cjrnd/TEMiWCZ_BLDC_HW/README.md

# TEMiWCZ_BLDC_HW

A BLDC driver which utilizes FOC algorithm.
<br />
<br />

### PCB
<p align="center">
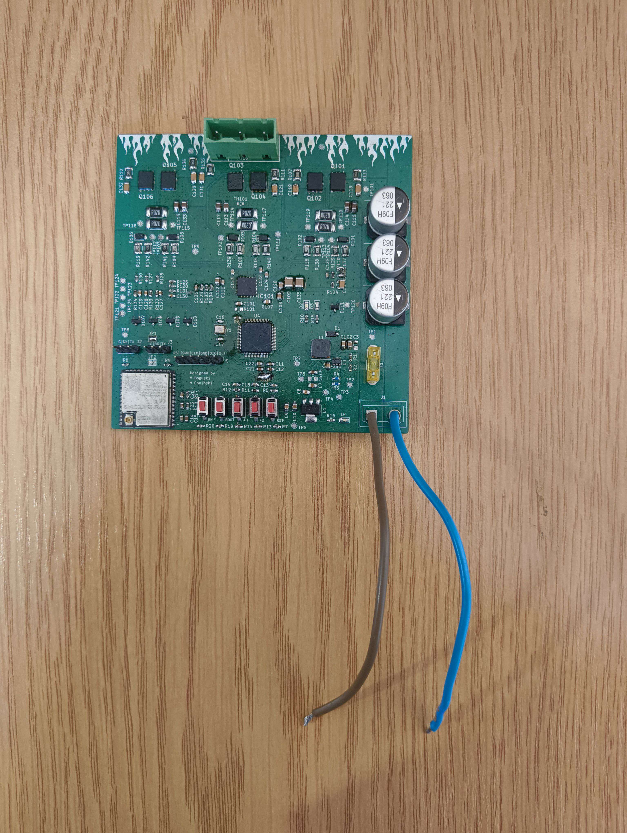
[picture p1: pictures/bldc_driver.jpg]
  
</p>

### TESTING

<p align="center">
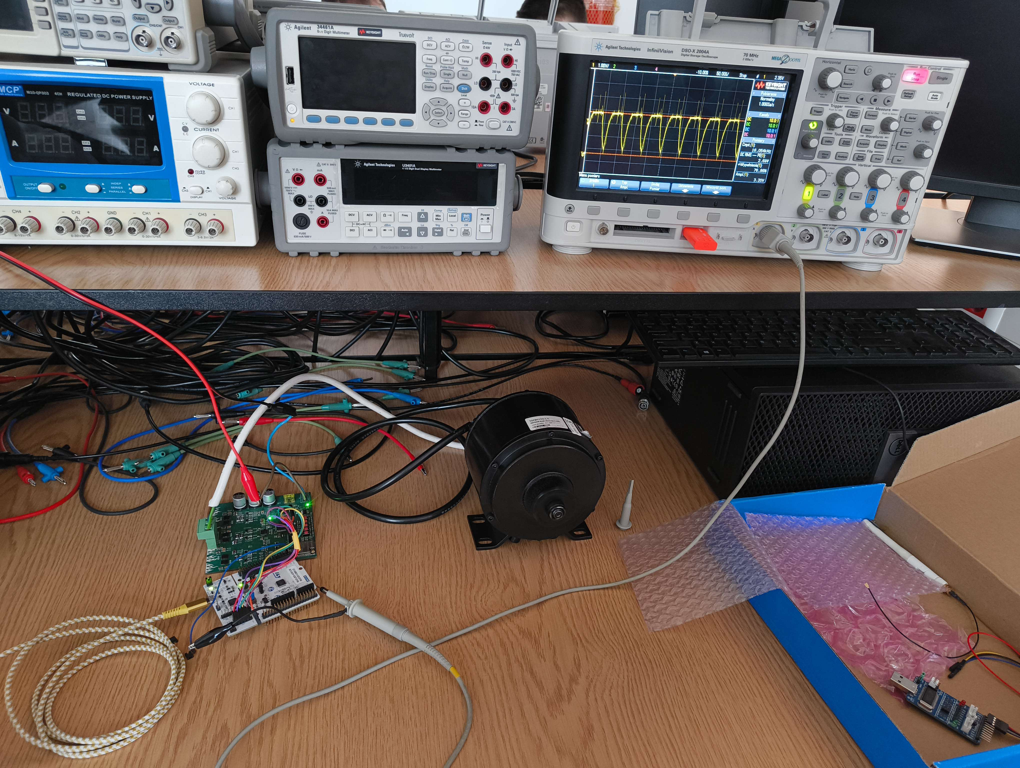
[picture p2: pictures/bldc_test.jpg]
  
</p>
