cjrnd/TEMiWCZ_BLDC_HW/BLDC_DRIVER/models&footprints/691311400103/Download_STP_691311400103_rev1.stp

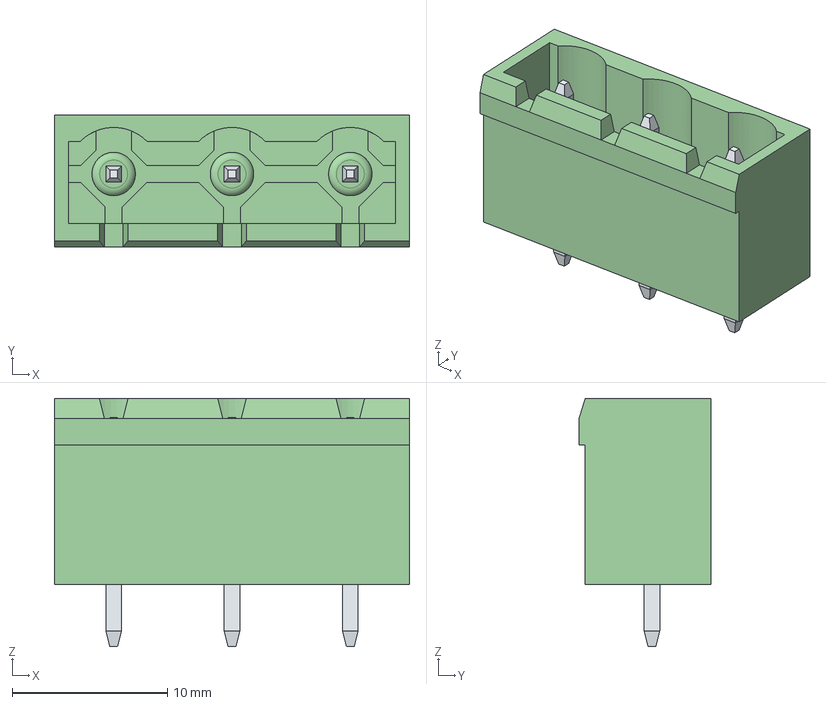
[picture p3: CAD file, 2025-04-12]
BLDC_DRIVER/models&footprints/691311400103/Download_STP_691311400103_rev1.stp
22.9 x 8.50 x 16.0 mm
6913114001xx_PIN x 3
