cjrnd/TEMiWCZ_BLDC_HW/BLDC_DRIVER/models&footprints/BAT54C/BAT54C.stp

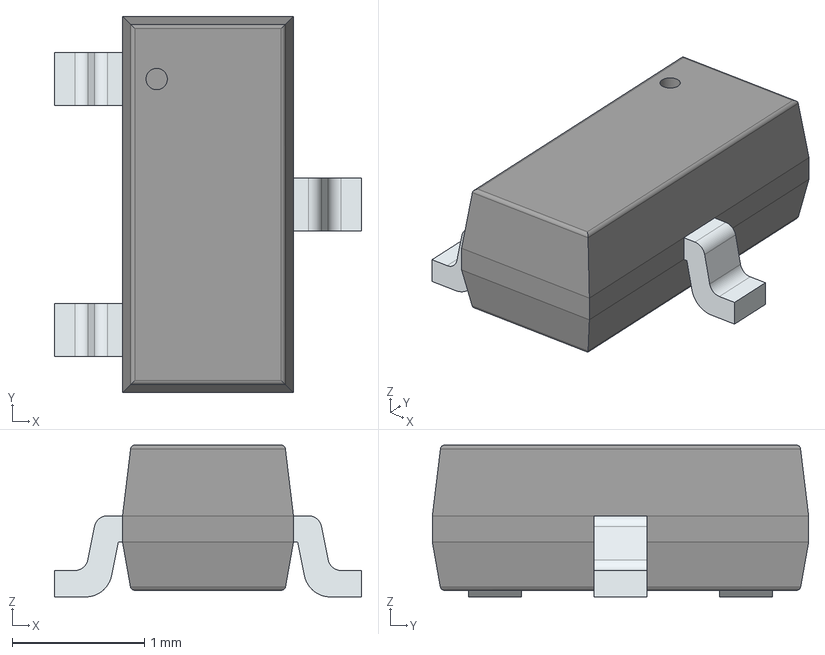
[picture p4: CAD file, 2025-04-06]
BLDC_DRIVER/models&footprints/BAT54C/BAT54C.stp
2.33 x 2.85 x 1.15 mm
PinsArrayL
FilletPinR
