cjrnd/TEMiWCZ_BLDC_HW/BLDC_DRIVER/models&footprints/BSC146N10LS5ATMA1/BSC146N10LS5ATMA1.stp

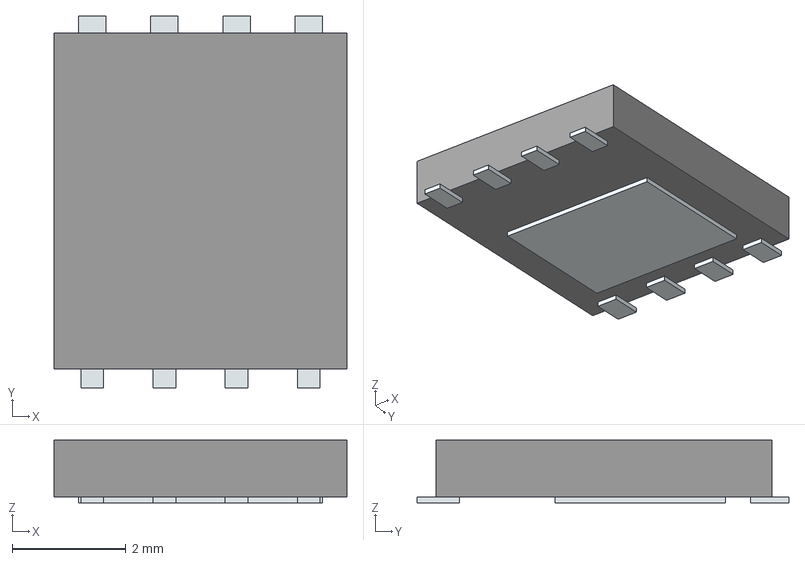
[picture p5: CAD file, 2025-04-12]
BLDC_DRIVER/models&footprints/BSC146N10LS5ATMA1/BSC146N10LS5ATMA1.stp
5.15 x 6.54 x 1.10 mm
Pins
