cjrnd/TEMiWCZ_BLDC_HW/BLDC_DRIVER/models&footprints/CDBC560-G/CDBC560-G.stp

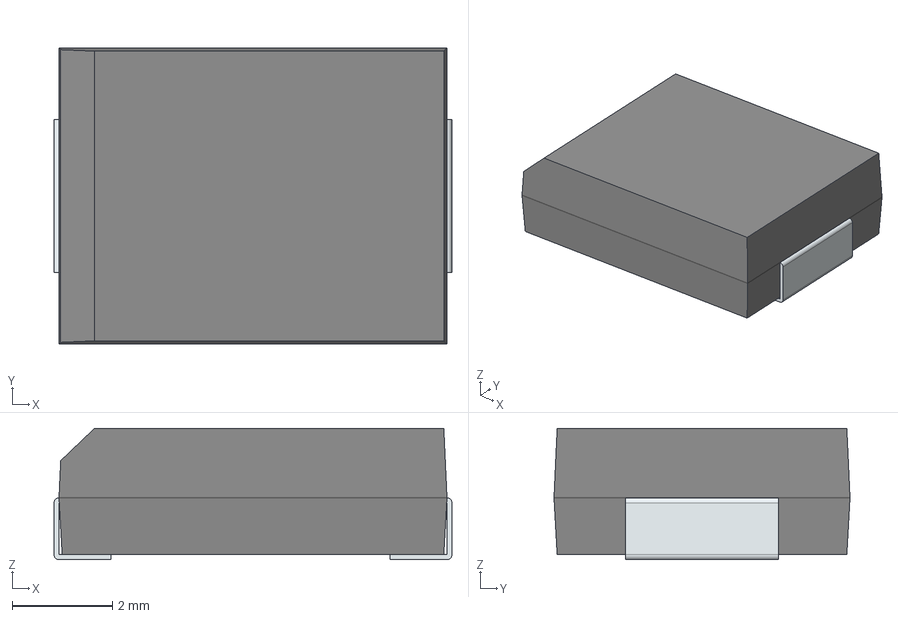
[picture p6: CAD file, 2025-04-12]
BLDC_DRIVER/models&footprints/CDBC560-G/CDBC560-G.stp
7.94 x 5.91 x 2.62 mm
FilletPin1
FilletPin2
