cjrnd/TEMiWCZ_BLDC_HW/BLDC_DRIVER/models&footprints/DRV8323/DRV8323SRTAR.stp

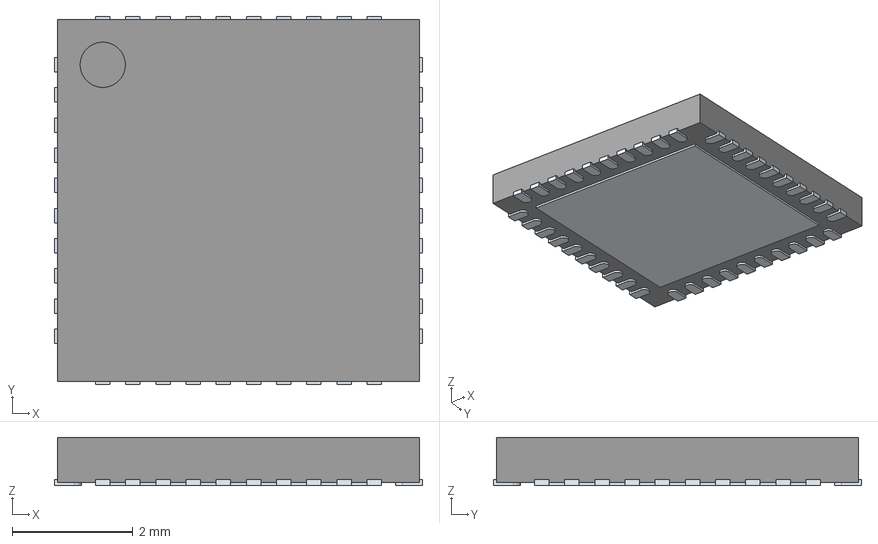
[picture p7: CAD file, 2025-04-06]
BLDC_DRIVER/models&footprints/DRV8323/DRV8323SRTAR.stp
6.10 x 6.10 x 0.8 mm
ThermalPin
PinsArrayLR
PinsArrayTB
