cjrnd/TEMiWCZ_BLDC_HW/BLDC_DRIVER/models&footprints/EMVY101ARA101MKE0S/EMVY101ARA101MKE0S.stp

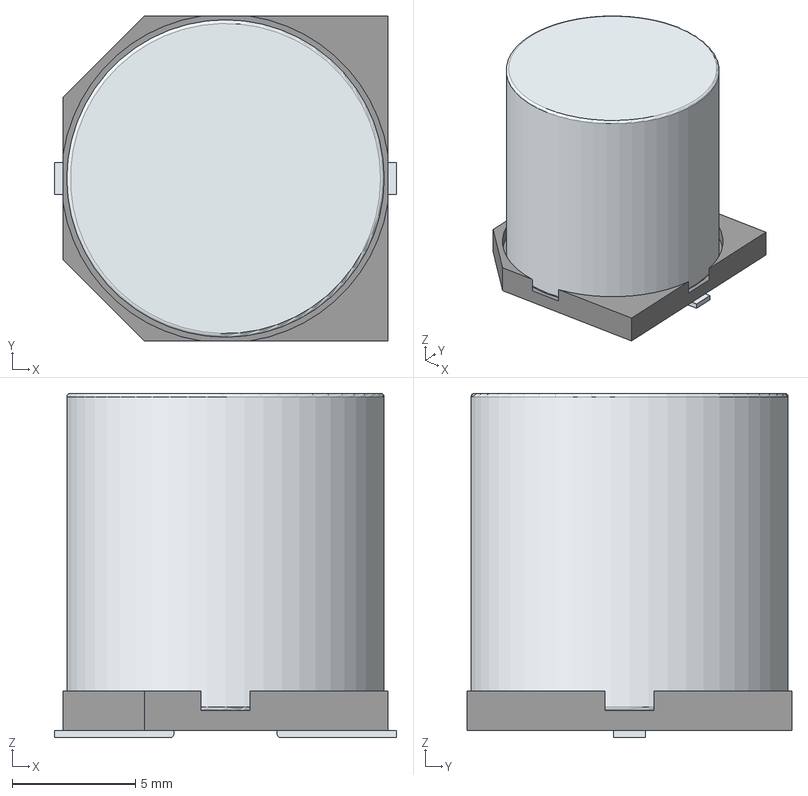
[picture p8: CAD file, 2025-04-06]
BLDC_DRIVER/models&footprints/EMVY101ARA101MKE0S/EMVY101ARA101MKE0S.stp
13.9 x 13.2 x 14.0 mm
Base
Pin1Fillet
Pin2Fillet
