cjrnd/TEMiWCZ_BLDC_HW/BLDC_DRIVER/models&footprints/ESP32-S3-WROOM-1U-N16R2/ESP32-S3-WROOM-1U-N16R2.step

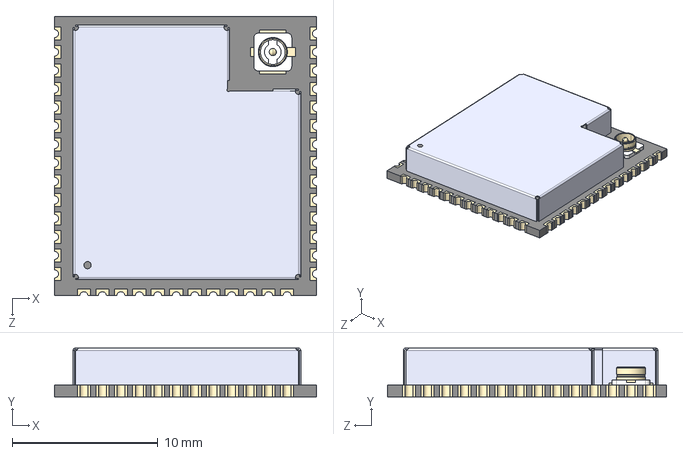
[picture p9: CAD file, 2025-04-09]
BLDC_DRIVER/models&footprints/ESP32-S3-WROOM-1U-N16R2/ESP32-S3-WROOM-1U-N16R2.step
18.0 x 3.35 x 19.2 mm
