cjrnd/TEMiWCZ_BLDC_HW/BLDC_DRIVER/models&footprints/NTMFS4D0N08XT1G/NTMFS4D0N08XT1G.stp

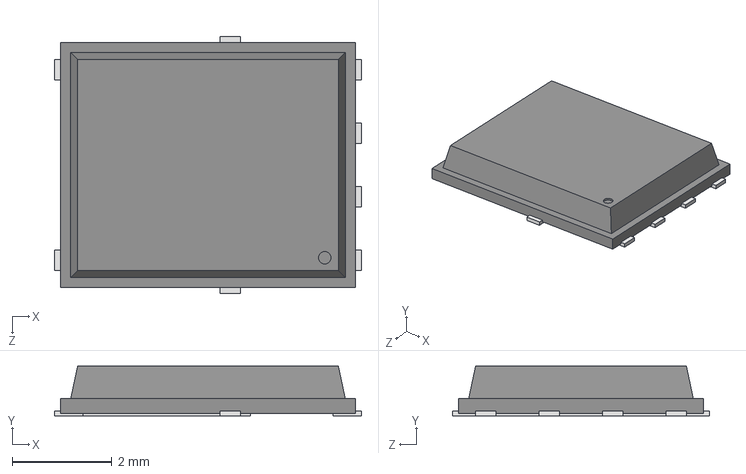
[picture p10: CAD file, 2025-04-16]
BLDC_DRIVER/models&footprints/NTMFS4D0N08XT1G/NTMFS4D0N08XT1G.stp
6.15 x 1 x 5.15 mm
