cjrnd/TEMiWCZ_BLDC_HW/BLDC_DRIVER/models&footprints/PM4343.102NLT/PM4343.102NLT.stp

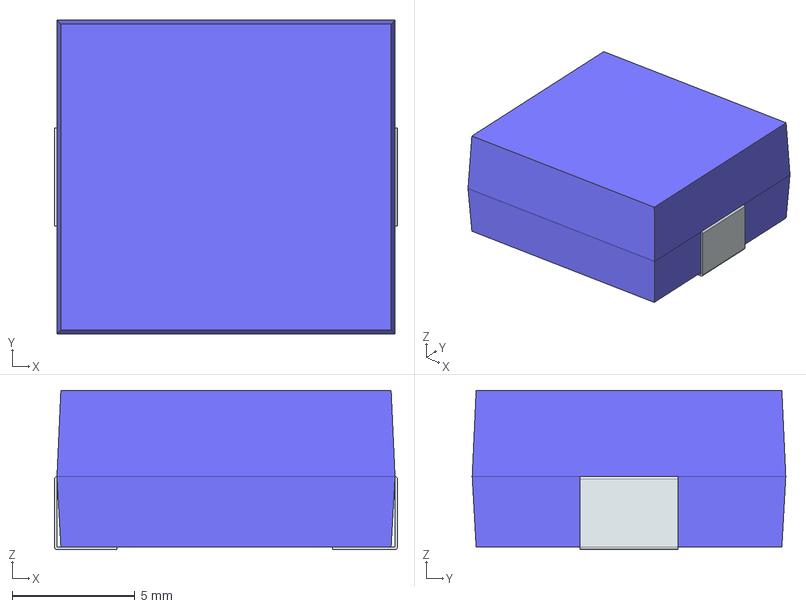
[picture p11: CAD file, 2025-04-06]
BLDC_DRIVER/models&footprints/PM4343.102NLT/PM4343.102NLT.stp
14.0 x 12.8 x 6.50 mm
FilletPin1
FilletPin2
