cjrnd/TEMiWCZ_BLDC_HW/BLDC_DRIVER/models&footprints/RF201L2SDDTE25/RF201L2SDDTE25.stp

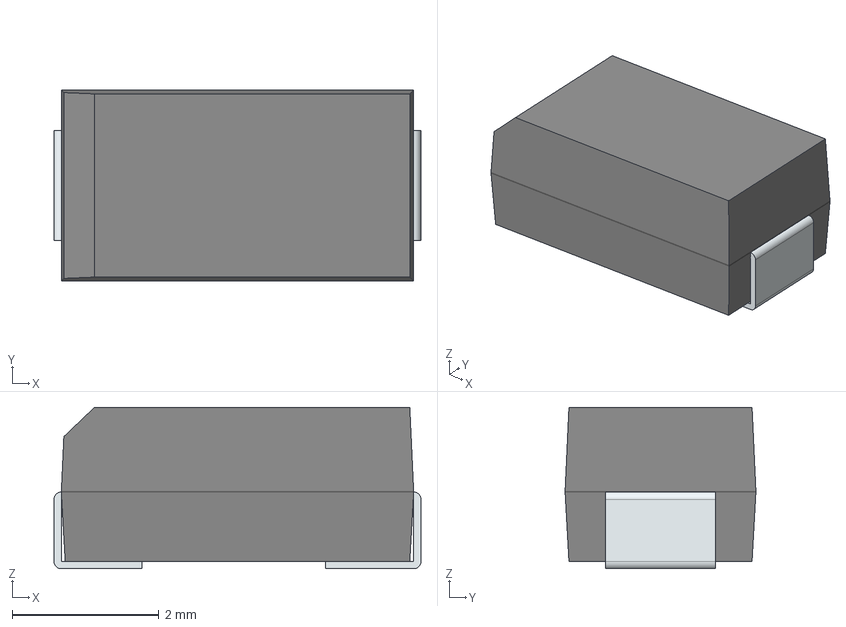
[picture p12: CAD file, 2025-04-06]
BLDC_DRIVER/models&footprints/RF201L2SDDTE25/RF201L2SDDTE25.stp
5.00 x 2.60 x 2.20 mm
FilletPin1
FilletPin2
