cjrnd/TEMiWCZ_BLDC_HW/BLDC_DRIVER/models&footprints/SBR3U60P1-7/SBR3U60P1-7.stp

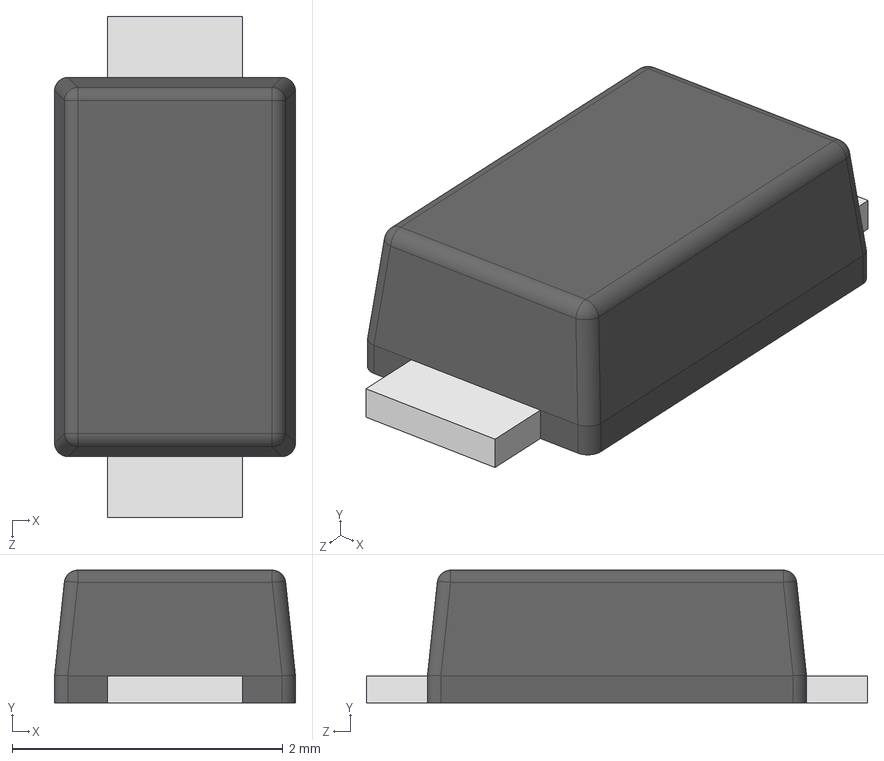
[picture p13: CAD file, 2025-04-12]
BLDC_DRIVER/models&footprints/SBR3U60P1-7/SBR3U60P1-7.stp
1.78 x 0.98 x 3.70 mm
