cjrnd/TEMiWCZ_BLDC_HW/BLDC_DRIVER/models&footprints/SBRT20U50SLPQ-13/SBRT20U50SLPQ-13.stp

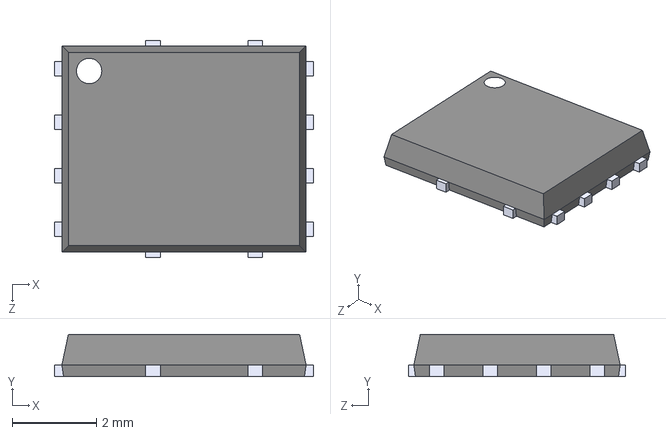
[picture p14: CAD file, 2025-04-12]
BLDC_DRIVER/models&footprints/SBRT20U50SLPQ-13/SBRT20U50SLPQ-13.stp
6.15 x 1.00 x 5.15 mm
