cjrnd/TEMiWCZ_BLDC_HW/BLDC_DRIVER/models&footprints/SQJ170ELP-T1_GE3/SQJ170ELP-T1_GE3.stp

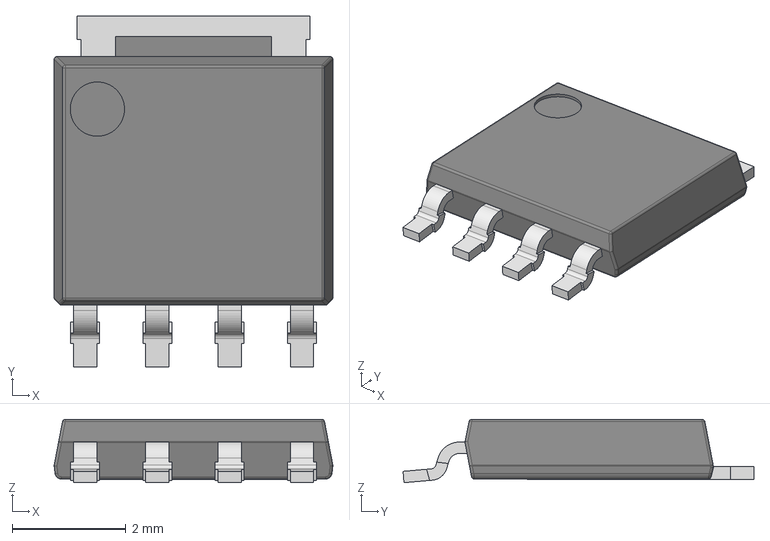
[picture p15: CAD file, 2025-04-06]
BLDC_DRIVER/models&footprints/SQJ170ELP-T1_GE3/SQJ170ELP-T1_GE3.stp
4.90 x 6.17 x 1.11 mm
