cjrnd/TEMiWCZ_BLDC_HW/BLDC_DRIVER/BLDC_DRIVER.kicad_pcb

## KiCad design BLDC_DRIVER/BLDC_DRIVER.kicad_pcb (2025-04-17)

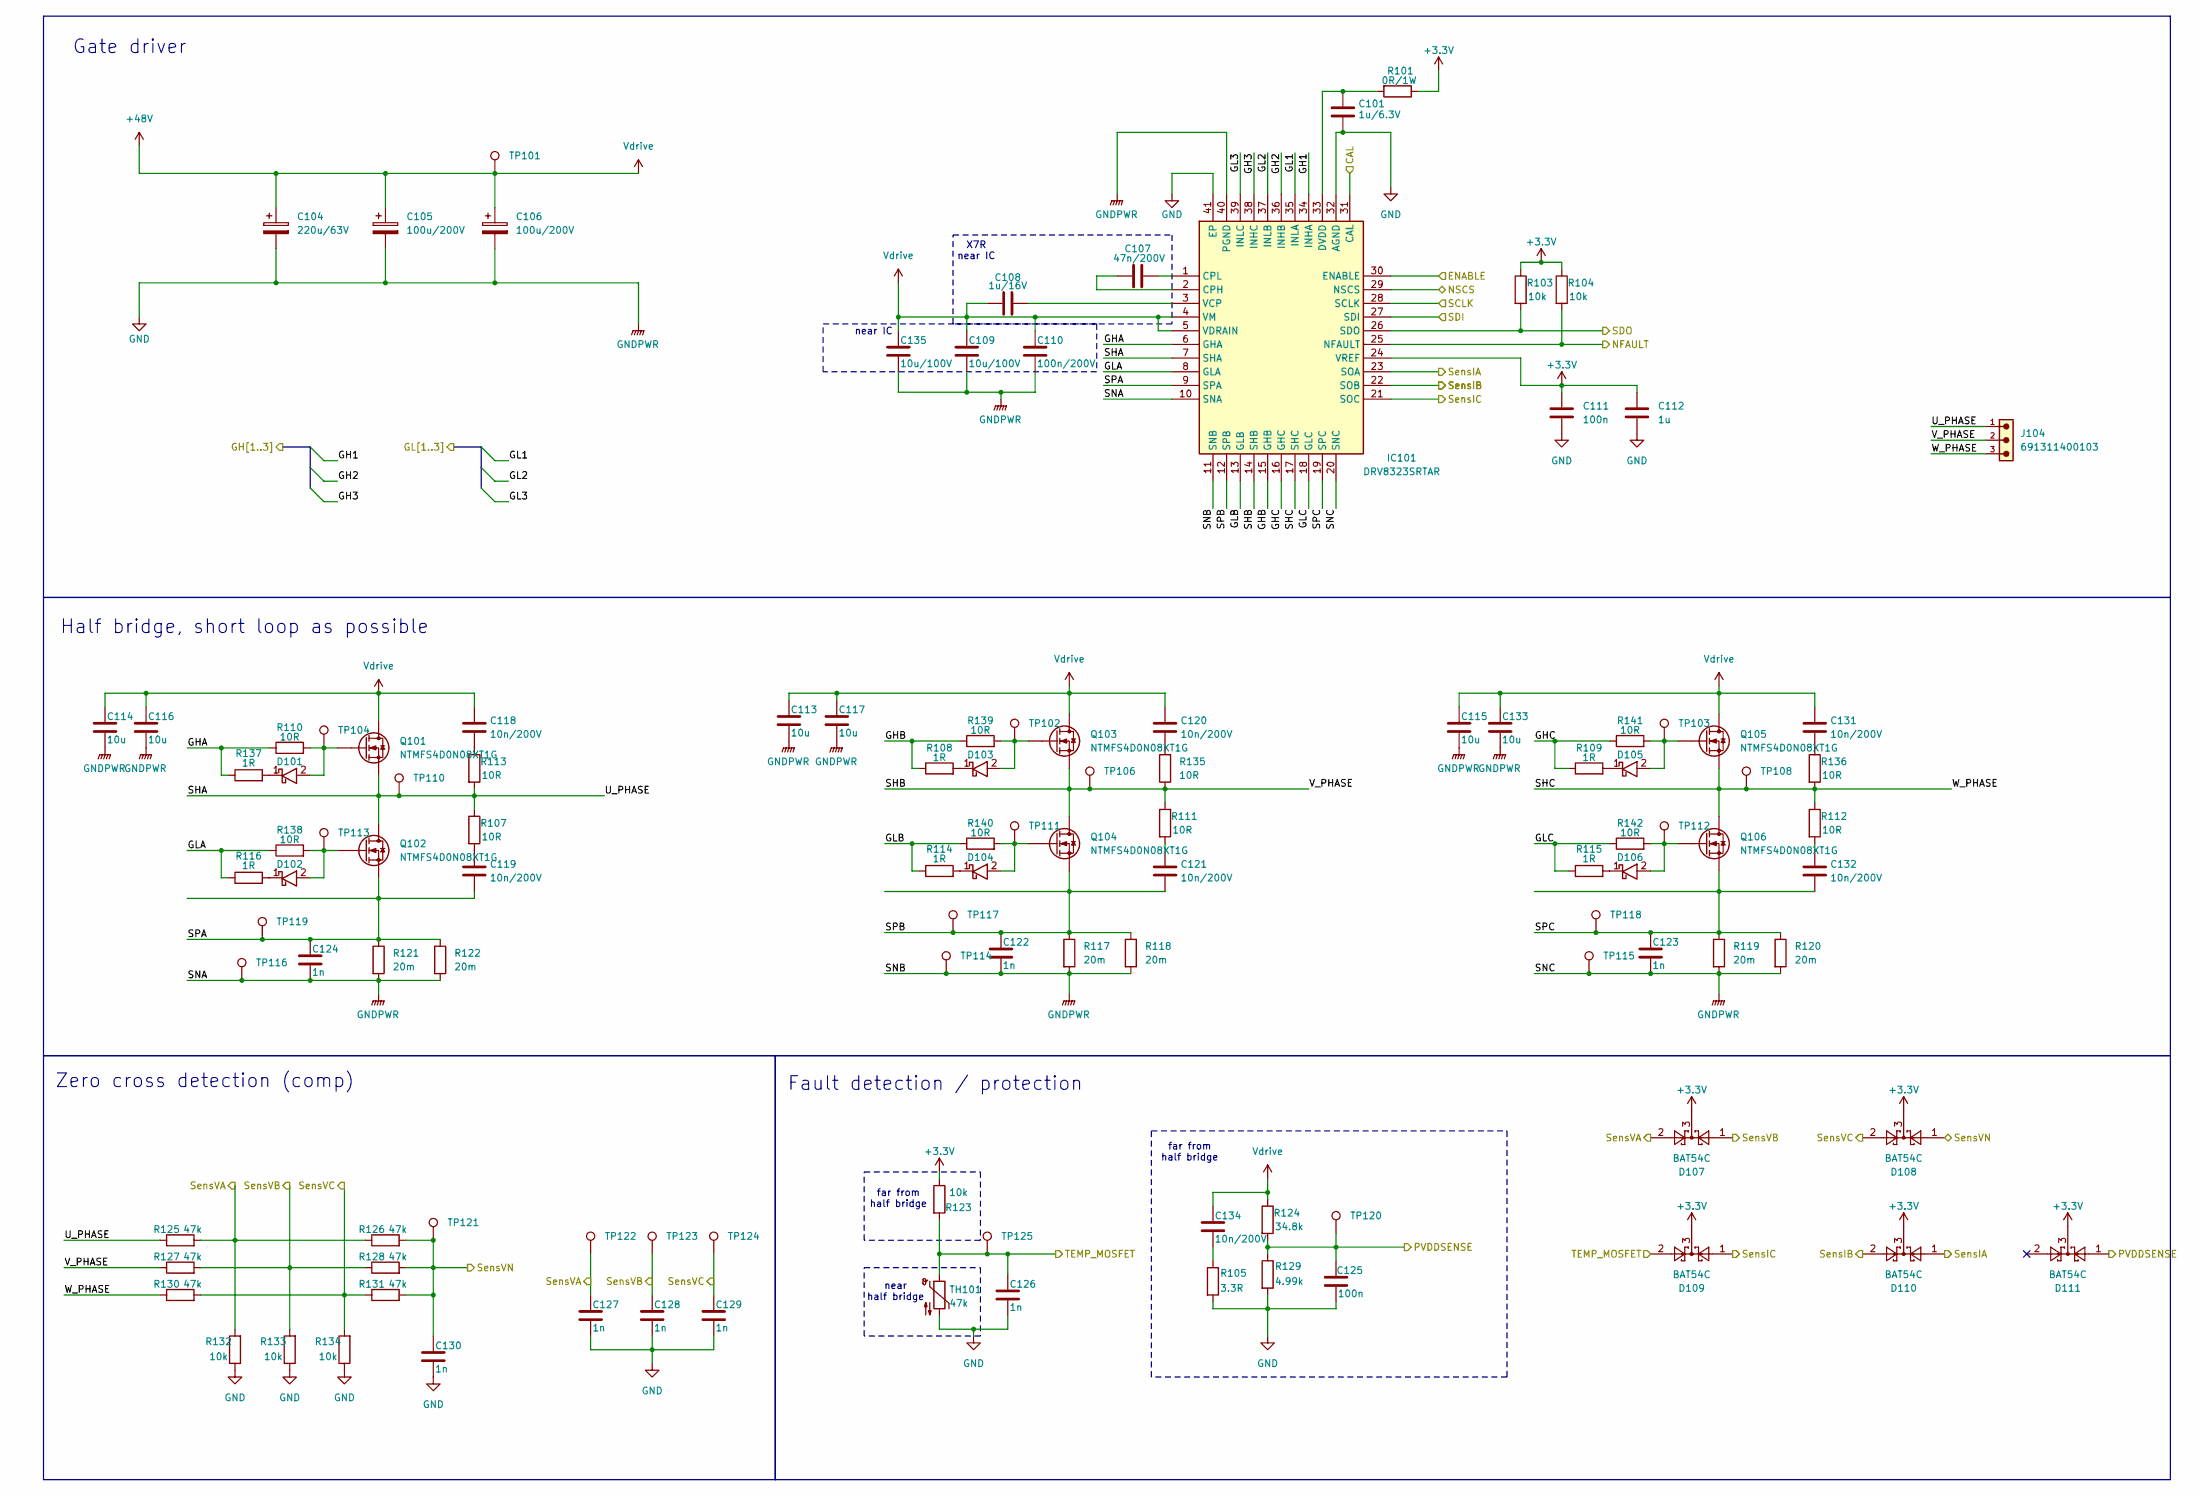
[picture p16: schematic Motor_driver.kicad_sch]

Parts:
C101: 1u/6.3V; C_0603_1608Metric
C104: 220u/63V; CAPAE1300X1400N
C105, C106: 100u/200V; CAPAE1300X1400N
C107: 47n/200V; C_0805_2012Metric
C108: 1u/16V; C_0805_2012Metric
C109, C135: 10u/100V; C_1210_3225Metric
C110: 100n/200V; C_0805_2012Metric
C111, C125: 100n; C_0603_1608Metric
C112: 1u; C_0805_2012Metric
C113, C114, C115, C116, C117, C133: 10u; C_1206_3216Metric
C118, C119, C120, C121, C131, C132: 10n/200V; C_1206_3216Metric
C122, C123, C124, C126, C127, C128, C129, C130: 1n; C_0603_1608Metric
C134: 10n/200V; C_0805_2012Metric
D101, D102, D103, D104, D105, D106: SBR3U60P1-7; D_PowerDI-123; Mouser Part Number 621-SBR3U60P1-7
D107, D108, D109, D110, D111: BAT54C; SOT-23
IC101: DRV8323SRTAR; QFN50P600X600X80-41N-D; Mouser Part Number 595-DRV8323SRTAR
J104: 691311400103
Q101, Q102, Q103, Q104, Q105, Q106: NTMFS4D0N08XT1G; NRVTS10100EMFST1G; Mouser Part Number 863-NTMFS4D0N08XT1G
R101: 0R/1W; R_0805_2012Metric
R103, R104, R123, R132, R133, R134: 10k; R_0603_1608Metric
R105: 3.3R; R_0805_2012Metric
R107, R110, R111, R112, R113, R135, R136, R138, R139, R140, R141, R142: 10R; R_1210_3225Metric
R108, R109, R114, R115, R116, R137: 1R; R_1210_3225Metric
R117, R118, R119, R120, R121, R122: 20m; R_2512_6332Metric
R124: 34.8k; R_0603_1608Metric
R125, R126, R127, R128, R130, R131: 47k; R_0603_1608Metric
R129: 4.99k; R_0603_1608Metric
TH101: 47k; R_0603_1608Metric
TP101, TP102, TP103, TP104, TP106, TP108, TP110, TP111, TP112, TP113, TP114, TP115, TP116, TP117, TP118, TP119, TP120, TP121, TP122, TP123, TP124, TP125: TestPoint; TestPoint_Pad_D1.5mm

Connections:
+3.3V: C111.1, C112.1, D107.3, D108.3, D109.3, D110.3, D111.3, IC101.24 (VREF), R101.1, R103.1, R104.1, R123.1; also elsewhere on the board
+48V: C104.1, C105.1, C106.1, C108.1, C109.1, C110.1, C113.1, C114.1, C115.1, C116.1, C117.1, C118.1, C120.1, C131.1, C133.1, C134.1, C135.1, IC101.4 (VM), IC101.5 (VDRAIN), Q101.5, Q103.5, Q105.5, R124.1, TP101.1; also elsewhere on the board
/MCU/CAL: IC101.31 (CAL); also elsewhere on the board
/MCU/ENABLE: IC101.30 (ENABLE); also elsewhere on the board
/MCU/GH1: IC101.34 (INHA); also elsewhere on the board
/MCU/GH2: IC101.36 (INHB); also elsewhere on the board
/MCU/GH3: IC101.38 (INHC); also elsewhere on the board
/MCU/GL1: IC101.35 (INLA); also elsewhere on the board
/MCU/GL2: IC101.37 (INLB); also elsewhere on the board
/MCU/GL3: IC101.39 (INLC); also elsewhere on the board
/MCU/NFAULT: IC101.25 (NFAULT), R104.2; also elsewhere on the board
/MCU/NSCS: IC101.29 (NSCS); also elsewhere on the board
/MCU/PVDDSENSE: C125.1, D111.1, R124.2, R129.1, TP120.1; also elsewhere on the board
/MCU/SCLK: IC101.28 (SCLK); also elsewhere on the board
/MCU/SDI: IC101.26 (SDO), R103.2; also elsewhere on the board
/MCU/SDO: IC101.27 (SDI); also elsewhere on the board
/MCU/SensIA: D110.1, IC101.23 (SOA); also elsewhere on the board
/MCU/SensIB: D110.2, IC101.22 (SOB); also elsewhere on the board
/MCU/SensIC: D109.1, IC101.21 (SOC); also elsewhere on the board
/MCU/SensVA: C127.1, D107.2, R125.2, R126.1, R132.2, TP122.1; also elsewhere on the board
/MCU/SensVB: C128.1, D107.1, R127.2, R128.1, R133.2, TP123.1; also elsewhere on the board
/MCU/SensVC: C129.1, D108.2, R130.2, R131.1, R134.2, TP124.1; also elsewhere on the board
/MCU/SensVN: C130.1, D108.1, R126.2, R128.2, R131.2, TP121.1; also elsewhere on the board
/MCU/TEMP_MOSFET: C126.1, D109.2, R123.2, TH101.1, TP125.1; also elsewhere on the board
/Motor_driver/GHA: IC101.6 (GHA), R110.1, R137.1
/Motor_driver/GHB: IC101.15 (GHB), R108.1, R139.1
/Motor_driver/GHC: IC101.16 (GHC), R109.1, R141.1
/Motor_driver/GLA: IC101.8 (GLA), R116.1, R138.1
/Motor_driver/GLB: IC101.13 (GLB), R114.1, R140.1
/Motor_driver/GLC: IC101.18 (GLC), R115.1, R142.1
/Motor_driver/SHA: IC101.7 (SHA), J104.1, Q101.1, Q102.5, R107.1, R113.2, R125.1, TP110.1
/Motor_driver/SHB: IC101.14 (SHB), J104.2, Q103.1, Q104.5, R111.1, R127.1, R135.1, TP106.1
/Motor_driver/SHC: IC101.17 (SHC), J104.3, Q105.1, Q106.5, R112.1, R130.1, R136.2, TP108.1
/Motor_driver/SPA: C119.2, C124.1, IC101.9 (SPA), Q102.1, R121.1, R122.1, TP119.1
/Motor_driver/SPB: C121.2, C122.1, IC101.12 (SPB), Q104.1, R117.1, R118.1, TP117.1
/Motor_driver/SPC: C123.1, C132.2, IC101.19 (SPC), Q106.1, R119.1, R120.1, TP118.1
GND: C101.2, C104.2, C105.2, C106.2, C109.2, C110.2, C111.2, C112.2, C113.2, C114.2, C115.2, C116.2, C117.2, C122.2, C123.2, C124.2, C125.2, C126.2, C127.2, C128.2, C129.2, C130.2, C133.2, C135.2, IC101.10 (SNA), IC101.11 (SNB), IC101.20 (SNC), IC101.32 (AGND), IC101.40 (PGND), IC101.41 (EP), R105.2, R117.2, R118.2, R119.2, R120.2, R121.2, R122.2, R129.2, R132.1, R133.1, R134.1, TH101.2, TP114.1, TP115.1, TP116.1; also elsewhere on the board
unnamed: C118.2, R113.1
unnamed: C119.1, R107.2
unnamed: C120.2, R135.2
unnamed: C121.1, R111.2
unnamed: C131.2, R136.1
unnamed: C132.1, R112.2
unnamed: C134.2, R105.1
unnamed: D101.1, R137.2
unnamed: D101.2, Q101.4, R110.2, TP104.1
unnamed: D102.1, R116.2
unnamed: D102.2, Q102.4, R138.2, TP113.1
unnamed: D103.1, R108.2
unnamed: D103.2, Q103.4, R139.2, TP102.1
unnamed: D104.1, R114.2
unnamed: D104.2, Q104.4, R140.2, TP111.1
unnamed: D105.1, R109.2
unnamed: D105.2, Q105.4, R141.2, TP103.1
unnamed: D106.1, R115.2
unnamed: D106.2, Q106.4, R142.2, TP112.1
unnamed: C107.1, IC101.2 (CPH)
unnamed: C107.2, IC101.1 (CPL)
unnamed: C101.1, IC101.33 (DVDD), R101.2
unnamed: C108.2, IC101.3 (VCP)

Notes on the sheet:
Fault detection / protection
Gate driver
far from half bridge
X7R near IC
Zero cross detection (comp)
near half bridge
near IC
Half bridge, short loop as possible

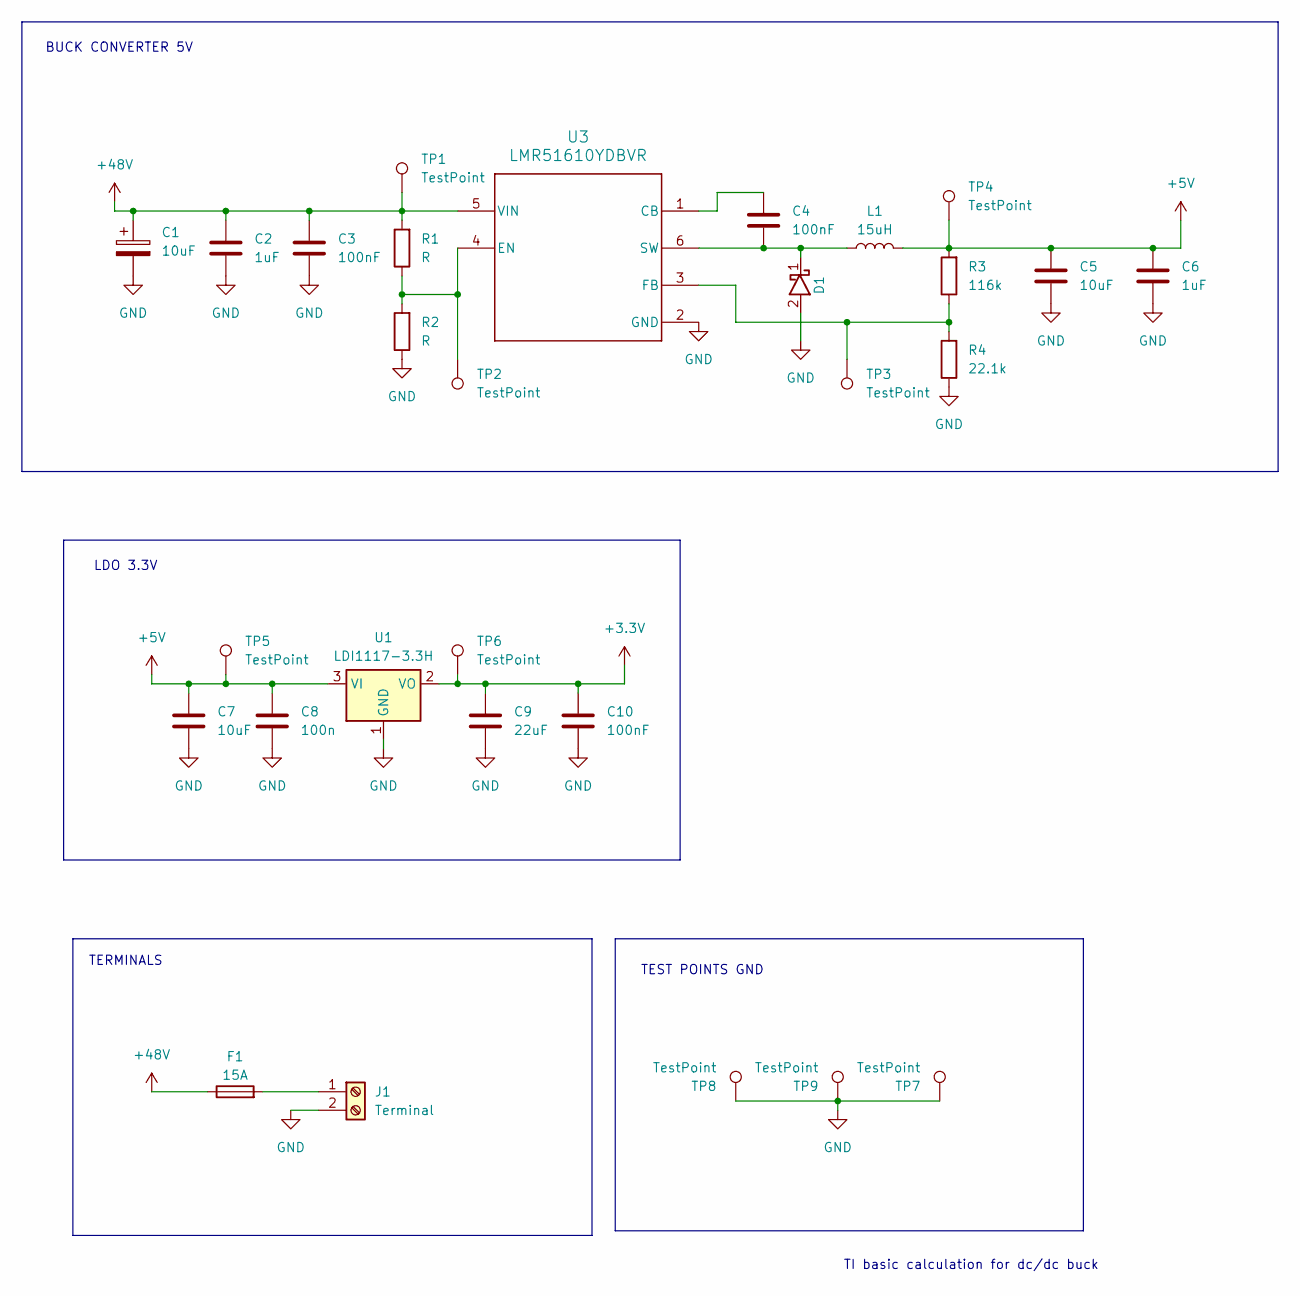
[picture p17: schematic power.kicad_sch]

Parts:
C1, C5, C7: 10uF; C_0805_2012Metric_Pad1.18x1.45mm_HandSolder
C2, C6: 1uF; C_0805_2012Metric_Pad1.18x1.45mm_HandSolder
C3, C10: 100nF; C_0805_2012Metric_Pad1.18x1.45mm_HandSolder
C4: 100nF; C_0603_1608Metric_Pad1.08x0.95mm_HandSolder
C8: 100n; C_0603_1608Metric_Pad1.08x0.95mm_HandSolder
C9: 22uF; C_0805_2012Metric_Pad1.18x1.45mm_HandSolder
D1: SBR3U60P1-7; D_PowerDI-123; Mouser Part Number 621-SBR3U60P1-7
F1: 15A; Fuse_Blade_Mini_directSolder
J1: Terminal; TerminalBlock_Wuerth_691311400102_P7.62mm
L1: 15uH; L_APV_ANR6045
R1, R2: R; R_0603_1608Metric_Pad0.98x0.95mm_HandSolder
R3: 116k; R_0603_1608Metric_Pad0.98x0.95mm_HandSolder
R4: 22.1k; R_0603_1608Metric_Pad0.98x0.95mm_HandSolder
TP1, TP2, TP3, TP4, TP5, TP6, TP7, TP8, TP9: TestPoint; TestPoint_Pad_D1.5mm
U1: LDI1117-3.3H; SOT-223-3_TabPin2
U3: LMR51610YDBVR; SOT-23-6

Connections:
+3.3V: C9.1, C10.1, TP6.1, U1.2 (VO); also elsewhere on the board
+5V: C5.2, C6.2, C7.1, C8.1, L1.2, R3.2, TP4.1, TP5.1, U1.3 (VI)
+48V: C1.1, C2.1, C3.2, F1.1, R1.2, TP1.1, U3.5 (VIN); also elsewhere on the board
GND: C1.2, C2.2, C3.1, C5.1, C6.1, C7.2, C8.2, C9.2, C10.2, D1.2, J1.2, R2.1, R4.1, TP7.1, TP8.1, TP9.1, U1.1 (GND), U3.2 (GND); also elsewhere on the board
unnamed: F1.2, J1.1
unnamed: C4.2, U3.1 (CB)
unnamed: R1.1, R2.2, TP2.1, U3.4 (EN)
unnamed: R3.1, R4.2, TP3.1, U3.3 (FB)
unnamed: C4.1, D1.1, L1.1, U3.6 (SW)

Notes on the sheet:
LDO 3.3V
TEST POINTS GND
BUCK CONVERTER 5V
TI basic calculation for dc/dc buck
TERMINALS

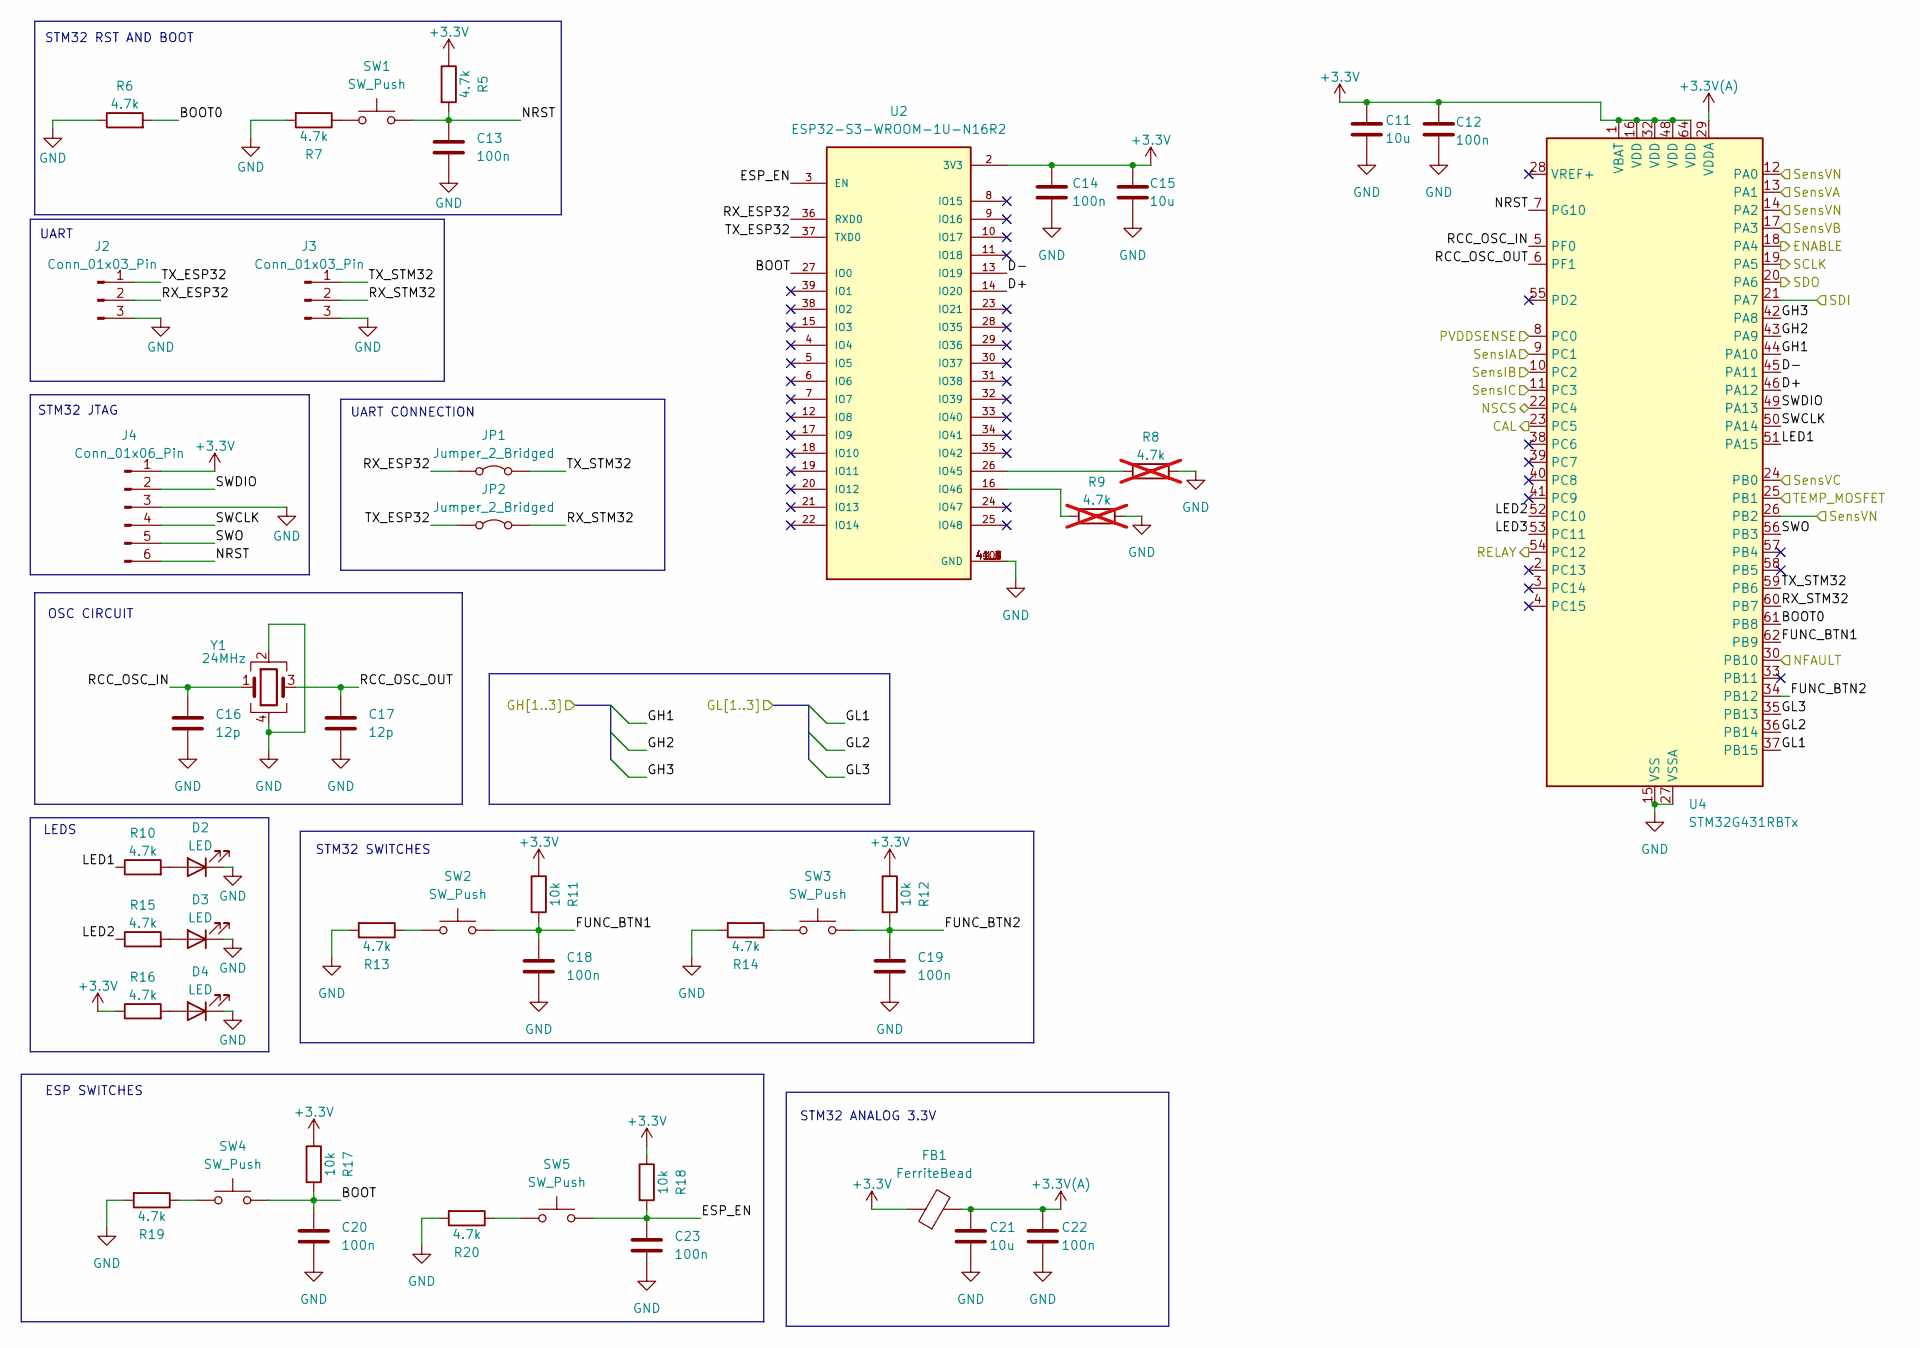
[picture p18: schematic mcu.kicad_sch]

Parts:
C11, C15, C21: 10u; C_0603_1608Metric_Pad1.08x0.95mm_HandSolder
C12, C13, C14, C18, C19, C20, C22, C23: 100n; C_0603_1608Metric_Pad1.08x0.95mm_HandSolder
C16, C17: 12p; C_0603_1608Metric_Pad1.08x0.95mm_HandSolder
D2, D3, D4: LED; D_0805_2012Metric_Pad1.15x1.40mm_HandSolder
FB1: FerriteBead; L_0805_2012Metric_Pad1.05x1.20mm_HandSolder
J2, J3: Conn_01x03_Pin; PinHeader_1x03_P2.54mm_Vertical
J4: Conn_01x06_Pin; PinHeader_1x06_P2.54mm_Vertical
JP1, JP2: Jumper_2_Bridged; SolderJumper-2_P1.3mm_Open_TrianglePad1.0x1.5mm
R5, R6, R7, R10, R13, R14, R15, R16, R19, R20: 4.7k; R_0603_1608Metric_Pad0.98x0.95mm_HandSolder
R8, R9: 4.7k; R_0603_1608Metric; not fitted
R11, R12, R17, R18: 10k; R_0603_1608Metric_Pad0.98x0.95mm_HandSolder
SW1, SW2, SW3, SW4, SW5: SW_Push; SW_Tactile_SPST_NO_Straight_CK_PTS636Sx25SMTRLFS
U2: ESP32-S3-WROOM-1U-N16R2; XCVR_ESP32-S3-WROOM-1U-N16R2; PARTREV v1.1
U4: STM32G431RBTx; LQFP-64_10x10mm_P0.5mm
Y1: 24MHz; Crystal_SMD_3225-4Pin_3.2x2.5mm

Connections:
+3.3V: C11.2, C12.2, C14.2, C15.2, FB1.1, J4.1, R5.1, R11.1, R12.1, R16.1, R17.1, R18.1, U2.2 (3V3), U4.1 (VBAT), U4.16 (VDD), U4.32 (VDD), U4.48 (VDD), U4.64 (VDD); also elsewhere on the board
+3.3V(A): C21.2, C22.2, FB1.2, U4.29 (VDDA)
/MCU/BOOT: C20.2, R17.2, SW4.2, U2.27 (IO0)
/MCU/BOOT0: R6.2, U4.61 (PB8)
/MCU/CAL: U4.23 (PC5); also elsewhere on the board
/MCU/D+: U2.14 (IO20), U4.46 (PA12)
/MCU/D-: U2.13 (IO19), U4.45 (PA11)
/MCU/ENABLE: U4.18 (PA4); also elsewhere on the board
/MCU/ESP_EN: C23.2, R18.2, SW5.2, U2.3 (EN)
/MCU/FUNC_BTN1: C18.2, R11.2, SW2.2, U4.62 (PB9)
/MCU/FUNC_BTN2: C19.2, R12.2, SW3.2, U4.34 (PB12)
/MCU/GH1: U4.44 (PA10); also elsewhere on the board
/MCU/GH2: U4.43 (PA9); also elsewhere on the board
/MCU/GH3: U4.42 (PA8); also elsewhere on the board
/MCU/GL1: U4.37 (PB15); also elsewhere on the board
/MCU/GL2: U4.36 (PB14); also elsewhere on the board
/MCU/GL3: U4.35 (PB13); also elsewhere on the board
/MCU/LED1: R10.1, U4.51 (PA15)
/MCU/LED2: R15.1, U4.52 (PC10)
/MCU/LED3: U4.53 (PC11)
/MCU/NFAULT: U4.30 (PB10); also elsewhere on the board
/MCU/NRST: C13.2, J4.6, R5.2, SW1.2, U4.7 (PG10)
/MCU/NSCS: U4.22 (PC4); also elsewhere on the board
/MCU/PVDDSENSE: U4.8 (PC0); also elsewhere on the board
/MCU/RCC_OSC_IN: C16.2, U4.5 (PF0), Y1.1
/MCU/RCC_OSC_OUT: C17.2, U4.6 (PF1), Y1.3
/MCU/RELAY: U4.54 (PC12)
/MCU/RX_ESP32: J2.2, JP1.1 (A), U2.36 (RXD0)
/MCU/RX_STM32: J3.2, JP2.2 (B), U4.60 (PB7)
/MCU/SCLK: U4.19 (PA5); also elsewhere on the board
/MCU/SDI: U4.21 (PA7); also elsewhere on the board
/MCU/SDO: U4.20 (PA6); also elsewhere on the board
/MCU/SWCLK: J4.4, U4.50 (PA14)
/MCU/SWDIO: J4.2, U4.49 (PA13)
/MCU/SWO: J4.5, U4.56 (PB3)
/MCU/SensIA: U4.9 (PC1); also elsewhere on the board
/MCU/SensIB: U4.10 (PC2); also elsewhere on the board
/MCU/SensIC: U4.11 (PC3); also elsewhere on the board
/MCU/SensVA: U4.13 (PA1); also elsewhere on the board
/MCU/SensVB: U4.17 (PA3); also elsewhere on the board
/MCU/SensVC: U4.24 (PB0); also elsewhere on the board
/MCU/SensVN: U4.12 (PA0), U4.14 (PA2), U4.26 (PB2); also elsewhere on the board
/MCU/TEMP_MOSFET: U4.25 (PB1); also elsewhere on the board
/MCU/TX_ESP32: J2.1, JP2.1 (A), U2.37 (TXD0)
/MCU/TX_STM32: J3.1, JP1.2 (B), U4.59 (PB6)
GND: C11.1, C12.1, C13.1, C14.1, C15.1, C16.1, C17.1, C18.1, C19.1, C20.1, C21.1, C22.1, C23.1, D2.1 (K), D3.1 (K), D4.1 (K), J2.3, J3.3, J4.3, R6.1, R7.2, R8.2, R9.2, R13.2, R14.2, R19.2, R20.2, U2.1 (GND), U2.40 (GND), U2.41_1 (GND), U2.41_2 (GND), U2.41_3 (GND), U2.41_4 (GND), U2.41_5 (GND), U2.41_6 (GND), U2.41_7 (GND), U2.41_8 (GND), U2.41_9 (GND), U2.41_10, U2.41_11, U2.41_12, U2.41_13, U2.41_14, U2.41_15, U2.41_16, U2.41_17, U2.41_18, U2.41_19, U2.41_20, U2.41_21, U4.15 (VSS), U4.27 (VSSA), U4.31 (VSS), U4.47 (VSS), U4.63 (VSS), Y1.2, Y1.4; also elsewhere on the board
unnamed: D2.2 (A), R10.2
unnamed: D3.2 (A), R15.2
unnamed: D4.2 (A), R16.2
unnamed: R7.1, SW1.1
unnamed: R13.1, SW2.1
unnamed: R14.1, SW3.1
unnamed: R19.1, SW4.1
unnamed: R20.1, SW5.1
unnamed: R8.1, U2.26 (IO45)
unnamed: R9.1, U2.16 (IO46)

Notes on the sheet:
OSC CIRCUIT
LEDS
STM32 RST AND BOOT
UART
STM32 JTAG
ESP SWITCHES
UART CONNECTION
STM32 ANALOG 3.3V
STM32 SWITCHES

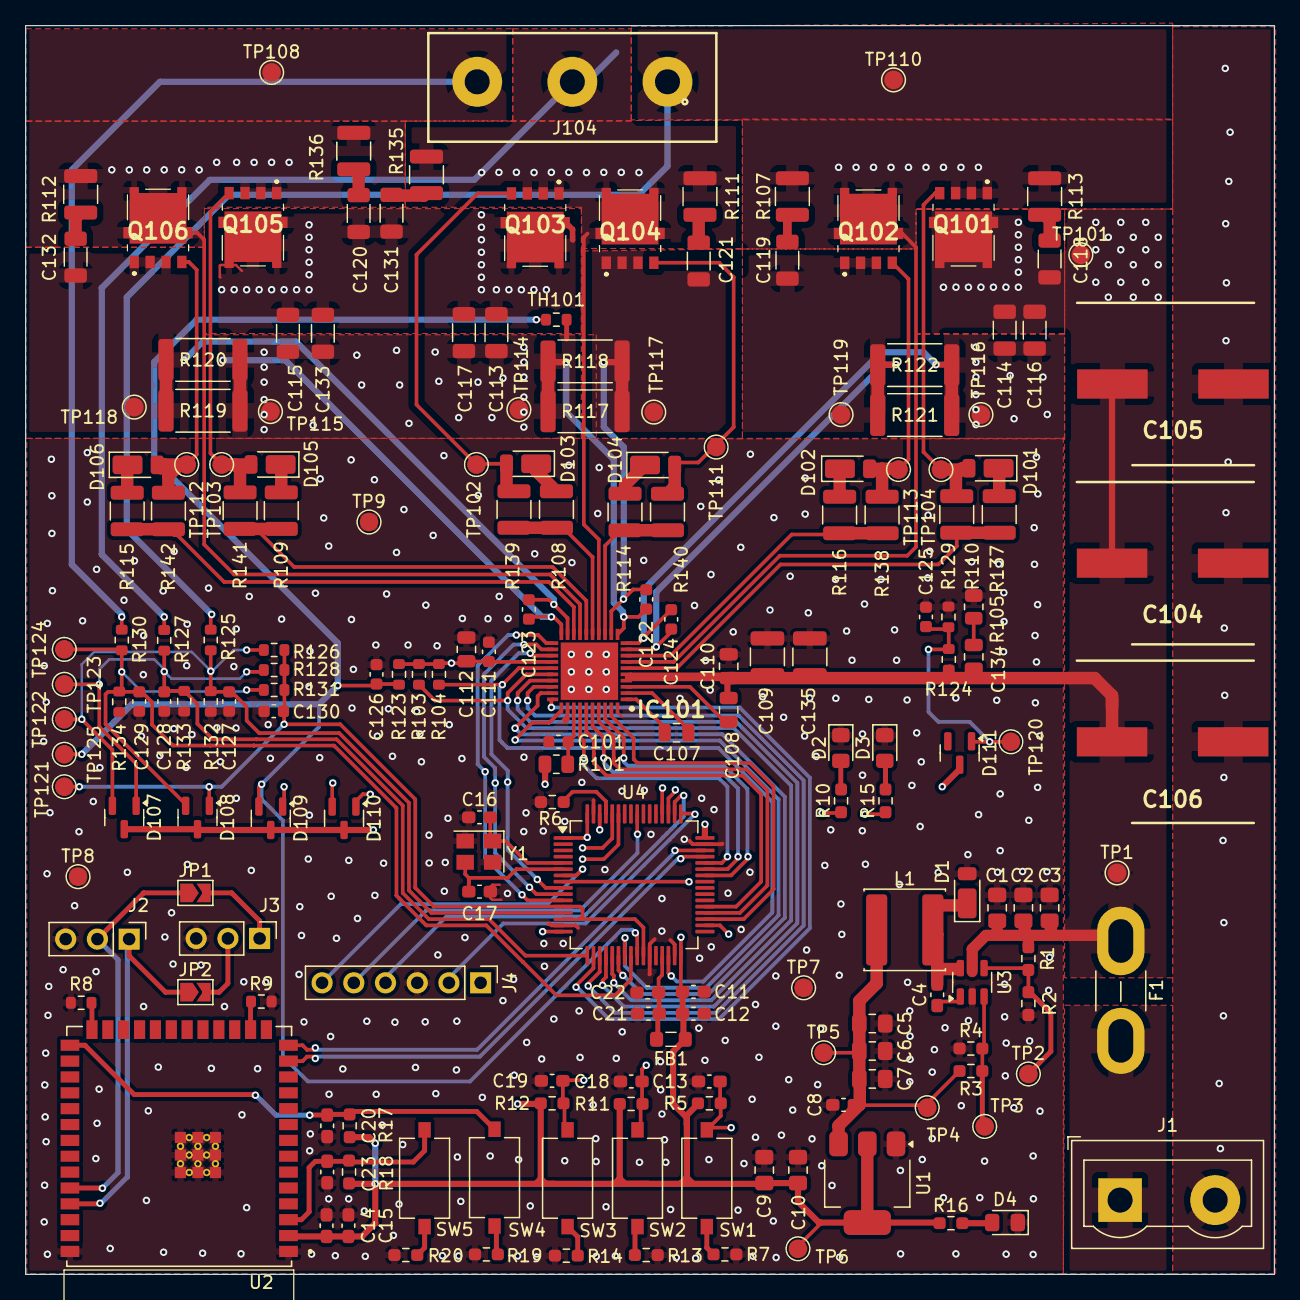
[picture p19: board BLDC_DRIVER.kicad_pcb from above]

Board: 4 copper layers, 100.0 x 100.0 mm, 190 parts (1 on the bottom side), 96 nets.
