cjrnd/TEMiWCZ_BLDC_HW/(commit log)

2025-03-26 buck and mcu added
    [BLDC_DRIVER.kicad_pcb, LM3404HVMA.step, mcu.kicad_sch, power.kicad_sch]
2025-03-30 added gate driver and igbt's
    [BLDC_DRIVER.kicad_sch, DRV8303DCAR.stp, Motor_driver.kicad_sch, driver_module_calc.xlsx]
2025-03-31 BEMF measurement
    [BLDC_DRIVER.kicad_sch, Motor_driver.kicad_sch, driver_module_calc.xlsx]
2025-04-01 ldo added
    [BLDC_DRIVER.kicad_sch, Motor_driver.kicad_sch, mcu.kicad_sch, power.kicad_sch]
2025-04-05 new driver
    [BLDC_DRIVER.kicad_sch, DRV8323SRTAR.stp, Motor_driver.kicad_sch, SQJ170ELP-T1_GE3.stp]
2025-04-06 added footprints, fault detection and temperature calc
    [BAT54C.stp, BLDC_DRIVER.kicad_sch, EMVY101ARA101MKE0S.stp, Motor_driver.kicad_sch, PM4343.102NLT.stp, RF201L2SDDTE25.stp, driver_module_calc.xlsx]
2025-04-09 mcu added
    [BLDC_DRIVER.kicad_sch, ESP32-S3-WROOM-1U-N16R2.step, LM5007MM.step, driver_module_calc.xlsx, mcu.kicad_sch, power.kicad_sch]
2025-04-09 snuber, removing spice
    [Motor_driver.kicad_sch, driver_module_calc.xlsx]
2025-04-09 footprints added, cap values corrected
    [BLDC_DRIVER.kicad_sch, DRV8303DCAR.stp, driver_module_calc.xlsx, mcu.kicad_sch, power.kicad_sch]
2025-04-10 buck changed and calculated
    [LM3404HVMA.step, LM5007MM.step, driver_module_calc.xlsx, mcu.kicad_sch, power.kicad_sch]
2025-04-11 fuses and missing footprints added, labels cleaned
    [BLDC_DRIVER.kicad_sch, driver_module_calc.xlsx, mcu.kicad_sch, power.kicad_sch]
2025-04-12 new mosfet and power connector
    [691311400103.step, BSC146N10LS5ATMA1.stp, CDBC560-G.stp, Download_STP_691311400103_rev1.stp, SBR3U60P1-7.stp, SBRT20U50SLPQ-13.stp]
2025-04-12 finall motor driver
    [BLDC_DRIVER.kicad_pcb, Motor_driver.kicad_sch, mcu.kicad_sch, power.kicad_sch]
2025-04-12 pcb update
    [BLDC_DRIVER.kicad_pcb]
2025-04-12 board constraints added
    [BLDC_DRIVER.kicad_pcb, BLDC_DRIVER.kicad_sch, Motor_driver.kicad_sch, power.kicad_sch]
2025-04-14 pre layout
    [BLDC_DRIVER.kicad_pcb, Motor_driver.kicad_sch, NTMFS4D0N08XT1G.stp, driver_module_calc.xlsx]
2025-04-14 motor driver layout v1
    [BLDC_DRIVER.kicad_pcb, Motor_driver.kicad_sch]
2025-04-16 via update
    [BLDC_DRIVER.kicad_pcb]
2025-04-16 esp/stm/ldo layout
    [BLDC_DRIVER.kicad_pcb, mcu.kicad_sch, power.kicad_sch]
2025-04-17 mcu&power final layout
    [BLDC_DRIVER.kicad_pcb, Motor_driver.kicad_sch, mcu.kicad_sch, power.kicad_sch]
